trappitsch/stage_controller/README.md

# Stage controller

Multi-axis stage controller repo.

## Crates

The project is divided into multiple crates.
The following list gives an overview.

- `axis_control`: Controls a single axis of a stage.
- `rp2350`: Firmware for stage controller running on an RP2350.
- `icd`: Interface control document: How the device talks to the host.
