trappitsch/stage_controller/hardware/dev_board/xy_table_dev_board.kicad_pcb

## KiCad design hardware/dev_board/xy_table_dev_board.kicad_pcb (2026-09-10)

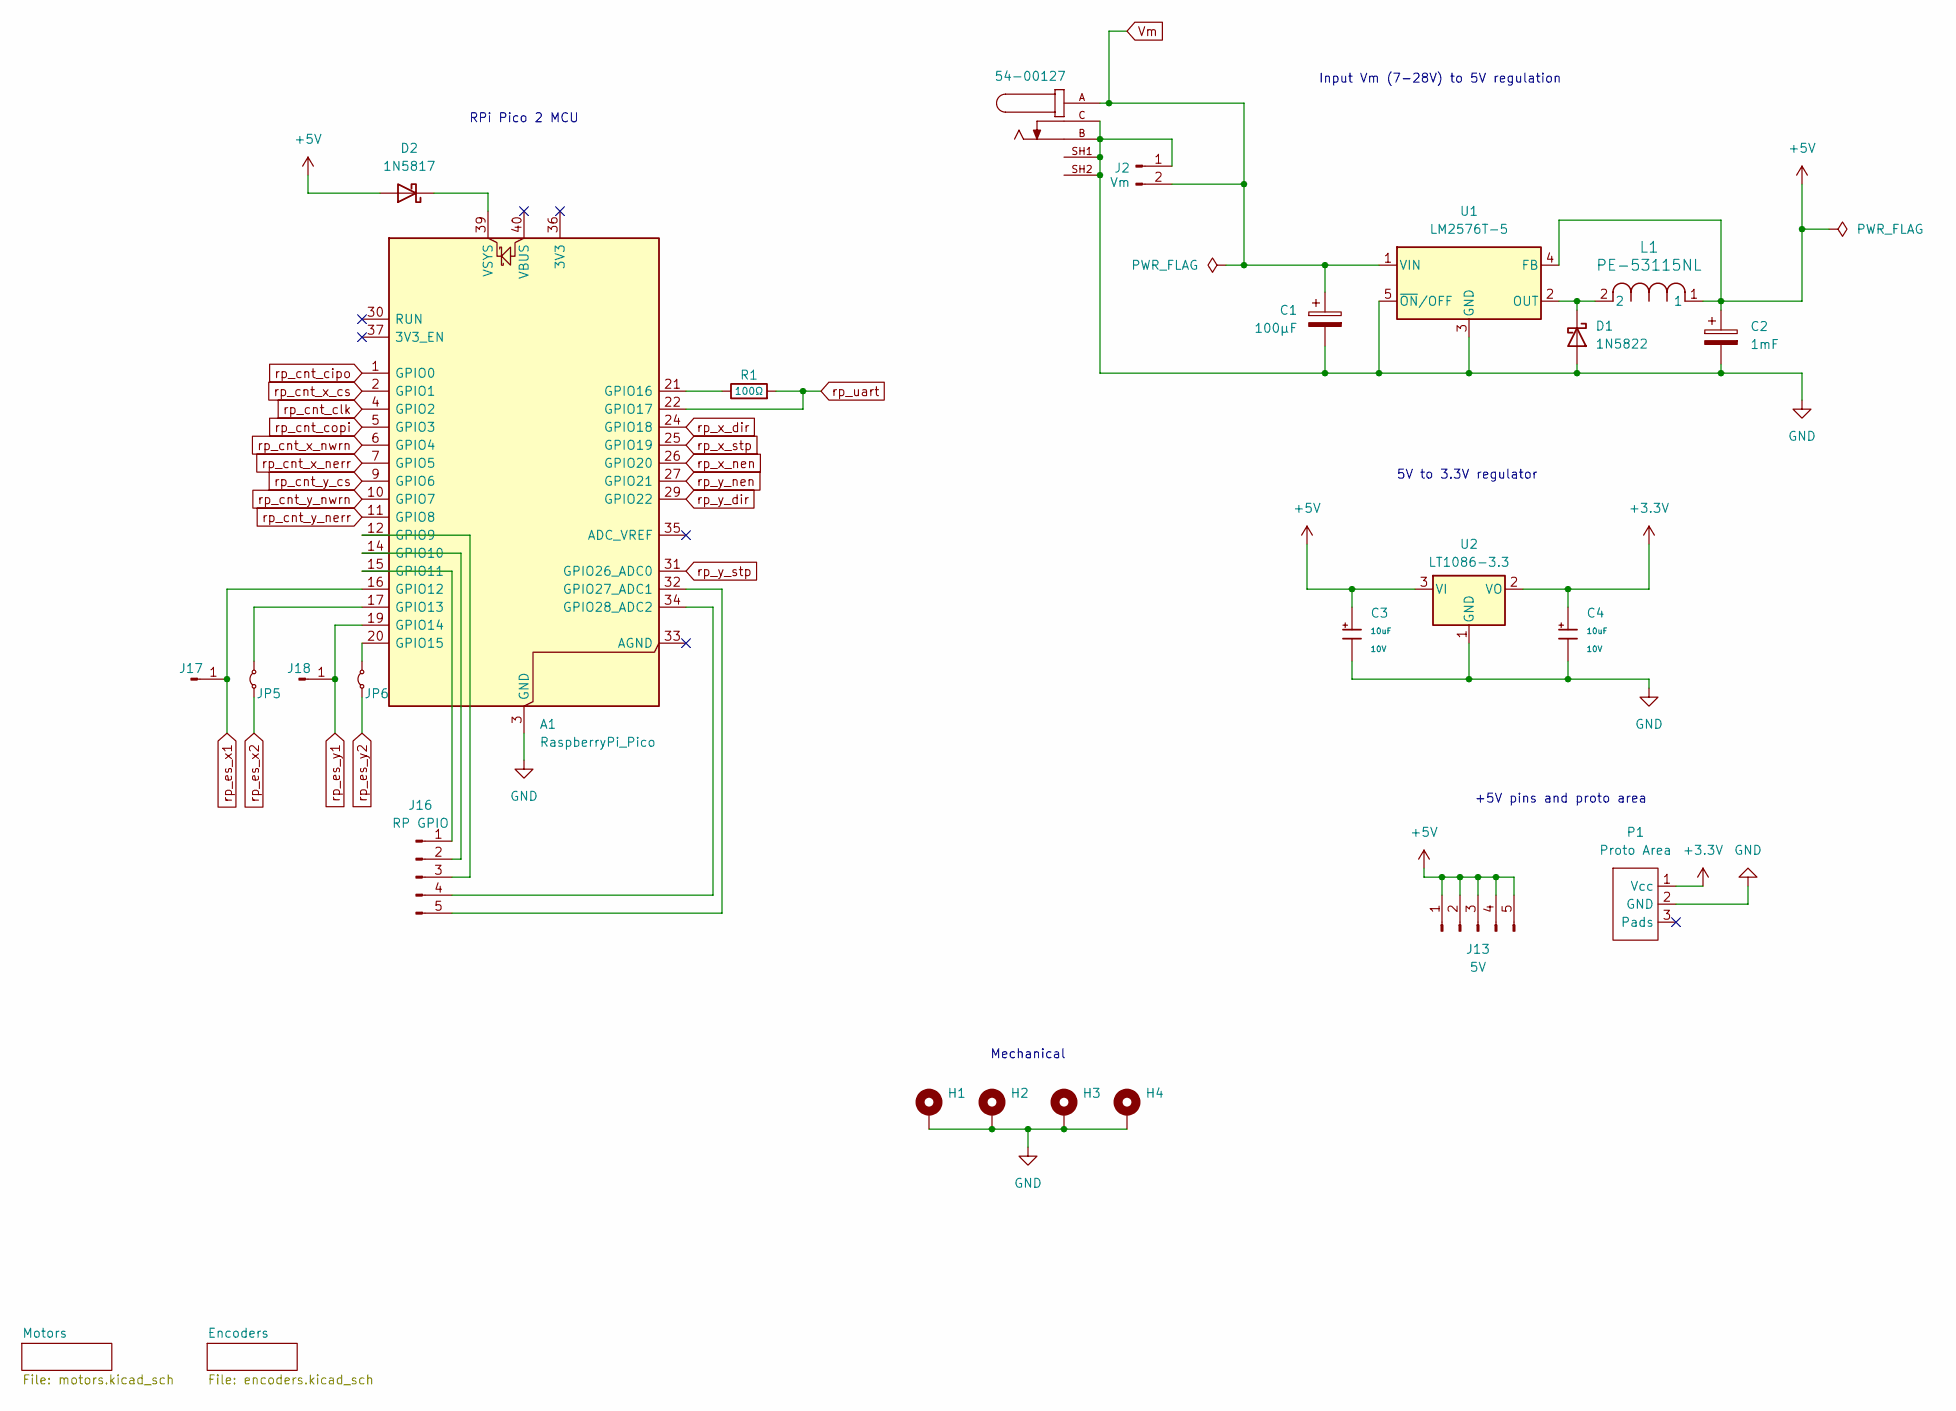
[picture p1: schematic xy_table_dev_board.kicad_sch, XY Table Development board]

Parts:
A1: RaspberryPi_Pico; RaspberryPi_Pico_Common_Unspecified
C1: 100µF; CP_Radial_D6.3mm_P2.50mm; Digikey 732-9215-1-ND
C2: 1mF; CP_Radial_D12.5mm_P5.00mm; Digikey 493-1322-ND
C3, C4: 10uF; C_1206_3216Metric_Pad1.33x1.80mm_HandSolder; Rated Voltage 10V; Digikey 478-11220-2-ND
D1: 1N5822; D_DO-201AD_P15.24mm_Horizontal; Digikey 497-11370-1-ND
D2: 1N5817; D_DO-41_SOD81_P10.16mm_Horizontal
H1, H2, H3, H4: MountingHole_Pad; MountingHole_3.2mm_M3_DIN965_Pad_TopBottom
J1: 54-00127; TENSILITY_54-00127; PARTREV A; Digikey 839-54-00127-ND
J2: Vm; PinHeader_1x02_P2.54mm_Vertical
J13: 5V; PinHeader_1x05_P2.54mm_Vertical
J16: RP GPIO; PinHeader_1x05_P2.54mm_Vertical
J17, J18: Conn_01x01_Pin; PinHeader_1x01_P2.54mm_Vertical
JP5, JP6: Jumper_2_Small_Bridged; TestPoint_2Pads_Pitch2.54mm_Drill0.8mm
L1: PE-53115NL; IND_PE-53115NL_PUL; Digikey 553-1566-5-ND
P1: Proto Area; proto_area_5x20_vcc_gnd
R1: 100Ω; R_1206_3216Metric_Pad1.30x1.75mm_HandSolder
U1: LM2576T-5; TO-220-5_Vertical; Digikey LM2576T-5.0/NOPB-ND
U2: LT1086-3.3; TO-220-3_Vertical

Connections:
+3.3V: C4.1, P1.1 (Vcc), U2.2 (VO); also elsewhere on the board
+5V: C2.1, C3.1, D2.2 (A), J13.1, J13.2, J13.3, J13.4, J13.5, L1.1, U1.4 (FB), U2.3 (VI); also elsewhere on the board
GND: A1.3 (GND), A1.8 (GND), A1.13 (GND), A1.18 (GND), A1.23 (GND), A1.28 (GND), A1.38 (GND), C1.2, C2.2, C3.2, C4.2, D1.2 (A), H1.1 (1_1), H2.1 (1_1), H3.1 (1_1), H4.1 (1_1), J1.B, J1.C, J1.SH1, J1.SH2, J2.1, P1.2 (GND), U1.3 (GND), U1.5 (~ON/OFF), U2.1 (GND); also elsewhere on the board
unnamed: A1.12 (GPIO9), J16.3
unnamed: A1.14 (GPIO10), J16.2
unnamed: A1.15 (GPIO11), J16.1
unnamed: A1.17 (GPIO13), JP5.2 (B)
unnamed: A1.20 (GPIO15), JP6.2 (B)
unnamed: A1.21 (GPIO16), R1.1
unnamed: A1.32 (GPIO27_ADC1), J16.5
unnamed: A1.34 (GPIO28_ADC2), J16.4
unnamed: A1.39 (VSYS), D2.1 (K)
unnamed: D1.1 (K), L1.2, U1.2 (OUT)
Vm: C1.1, J1.A, J2.2, U1.1 (VIN); also elsewhere on the board
rp_cnt_cipo: A1.1 (GPIO0); also elsewhere on the board
rp_cnt_clk: A1.4 (GPIO2); also elsewhere on the board
rp_cnt_copi: A1.5 (GPIO3); also elsewhere on the board
rp_cnt_x_cs: A1.2 (GPIO1); also elsewhere on the board
rp_cnt_x_nerr: A1.7 (GPIO5); also elsewhere on the board
rp_cnt_x_nwrn: A1.6 (GPIO4); also elsewhere on the board
rp_cnt_y_cs: A1.9 (GPIO6); also elsewhere on the board
rp_cnt_y_nerr: A1.11 (GPIO8); also elsewhere on the board
rp_cnt_y_nwrn: A1.10 (GPIO7); also elsewhere on the board
rp_es_x1: A1.16 (GPIO12), J17.1 (Pin_1_1); also elsewhere on the board
rp_es_x2: JP5.1 (A); also elsewhere on the board
rp_es_y1: A1.19 (GPIO14), J18.1 (Pin_1_1); also elsewhere on the board
rp_es_y2: JP6.1 (A); also elsewhere on the board
rp_uart: A1.22 (GPIO17), R1.2; also elsewhere on the board
rp_x_dir: A1.24 (GPIO18); also elsewhere on the board
rp_x_nen: A1.26 (GPIO20); also elsewhere on the board
rp_x_stp: A1.25 (GPIO19); also elsewhere on the board
rp_y_dir: A1.29 (GPIO22); also elsewhere on the board
rp_y_nen: A1.27 (GPIO21); also elsewhere on the board
rp_y_stp: A1.31 (GPIO26_ADC0); also elsewhere on the board

Notes on the sheet:
RPi Pico 2 MCU
Input Vm (7-28V) to 5V regulation
+5V pins and proto area
5V to 3.3V regulator
Mechanical

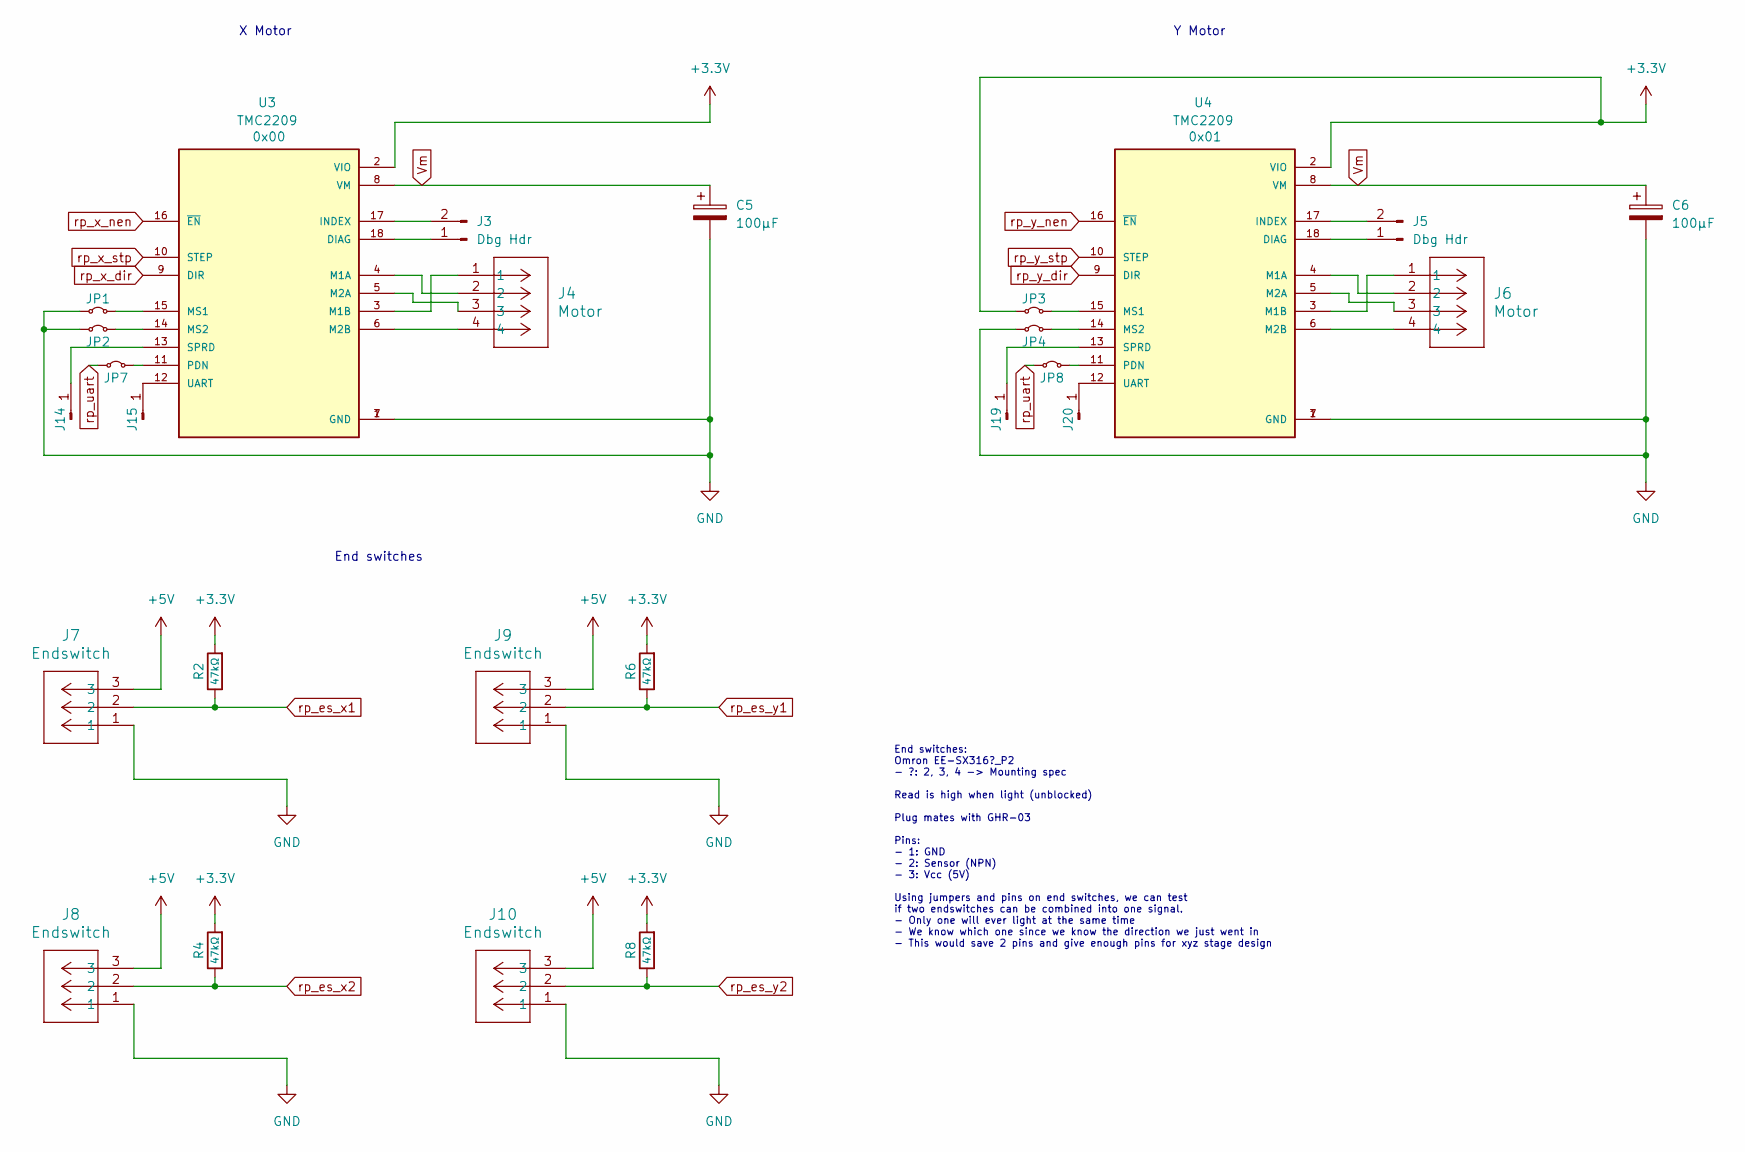
[picture p2: schematic motors.kicad_sch, XY Table Development board]

Parts:
C5, C6: 100µF; CP_Radial_D6.3mm_P2.50mm; Digikey 732-9215-1-ND
J3, J5: Dbg Hdr; PinHeader_1x02_P2.54mm_Vertical
J4, J6: Motor; CONN_A-6373-04A_MOL; Digikey WM2702-ND
J7, J8, J9, J10: Endswitch; CONN_A-6373-03A_MOL; Digikey WM2701-ND
J14, J15, J19, J20: Conn_01x01_Pin; PinHeader_1x01_P2.54mm_Vertical
JP1, JP2, JP3, JP4, JP7, JP8: Jumper_2_Small_Bridged; TestPoint_2Pads_Pitch2.54mm_Drill0.8mm
R2, R4, R6, R8: 47kΩ; R_Axial_DIN0207_L6.3mm_D2.5mm_P7.62mm_Horizontal; Digikey CF18JT47K0TR-ND
U3, U4: TMC2209; MODULE_TMC2209_SILENTSTEPSTICK; PARTREV 1.20

Connections:
+3.3V: JP3.1 (A), R2.2, R4.2, R6.2, R8.2, U3.2 (VIO), U4.2 (VIO); also elsewhere on the board
+5V: J7.3, J8.3, J9.3, J10.3; also elsewhere on the board
GND: C5.2, C6.2, J7.1, J8.1, J9.1, J10.1, JP1.1 (A), JP2.1 (A), JP4.1 (A), U3.1 (GND), U3.7 (GND), U4.1 (GND), U4.7 (GND); also elsewhere on the board
unnamed: J3.1, U3.18 (DIAG)
unnamed: J3.2, U3.17 (INDEX)
unnamed: J5.1, U4.18 (DIAG)
unnamed: J5.2, U4.17 (INDEX)
unnamed: J14.1 (Pin_1_1), U3.13 (SPRD)
unnamed: J15.1 (Pin_1_1), U3.12 (UART)
unnamed: J19.1 (Pin_1_1), U4.13 (SPRD)
unnamed: J20.1 (Pin_1_1), U4.12 (UART)
unnamed: JP1.2 (B), U3.15 (MS1)
unnamed: JP2.2 (B), U3.14 (MS2)
unnamed: JP3.2 (B), U4.15 (MS1)
unnamed: JP4.2 (B), U4.14 (MS2)
unnamed: JP7.2 (B), U3.11 (PDN)
unnamed: JP8.2 (B), U4.11 (PDN)
unnamed: J4.2, U3.4 (M1A)
unnamed: J4.1, U3.3 (M1B)
unnamed: J4.3, U3.5 (M2A)
unnamed: J4.4, U3.6 (M2B)
unnamed: J6.2, U4.4 (M1A)
unnamed: J6.1, U4.3 (M1B)
unnamed: J6.3, U4.5 (M2A)
unnamed: J6.4, U4.6 (M2B)
Vm: C5.1, C6.1, U3.8 (VM), U4.8 (VM); also elsewhere on the board
rp_es_x1: J7.2, R2.1; also elsewhere on the board
rp_es_x2: J8.2, R4.1; also elsewhere on the board
rp_es_y1: J9.2, R6.1; also elsewhere on the board
rp_es_y2: J10.2, R8.1; also elsewhere on the board
rp_uart: JP7.1 (A), JP8.1 (A); also elsewhere on the board
rp_x_dir: U3.9 (DIR); also elsewhere on the board
rp_x_nen: U3.16 (~EN); also elsewhere on the board
rp_x_stp: U3.10 (STEP); also elsewhere on the board
rp_y_dir: U4.9 (DIR); also elsewhere on the board
rp_y_nen: U4.16 (~EN); also elsewhere on the board
rp_y_stp: U4.10 (STEP); also elsewhere on the board

Notes on the sheet:
Y Motor
End switches: Omron EE-SX316?_P2 - ?: 2, 3, 4 -> Mounting spec Read is high when light (unblocked) Plug mates with GHR-03 Pins: - 1: GND - 2: Sensor (NPN) - 3: Vcc (5V) Using jumpers and pins on end switches, we can test if two endswitches can be combined into one signal. - Only one will ever light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
End switches
X Motor

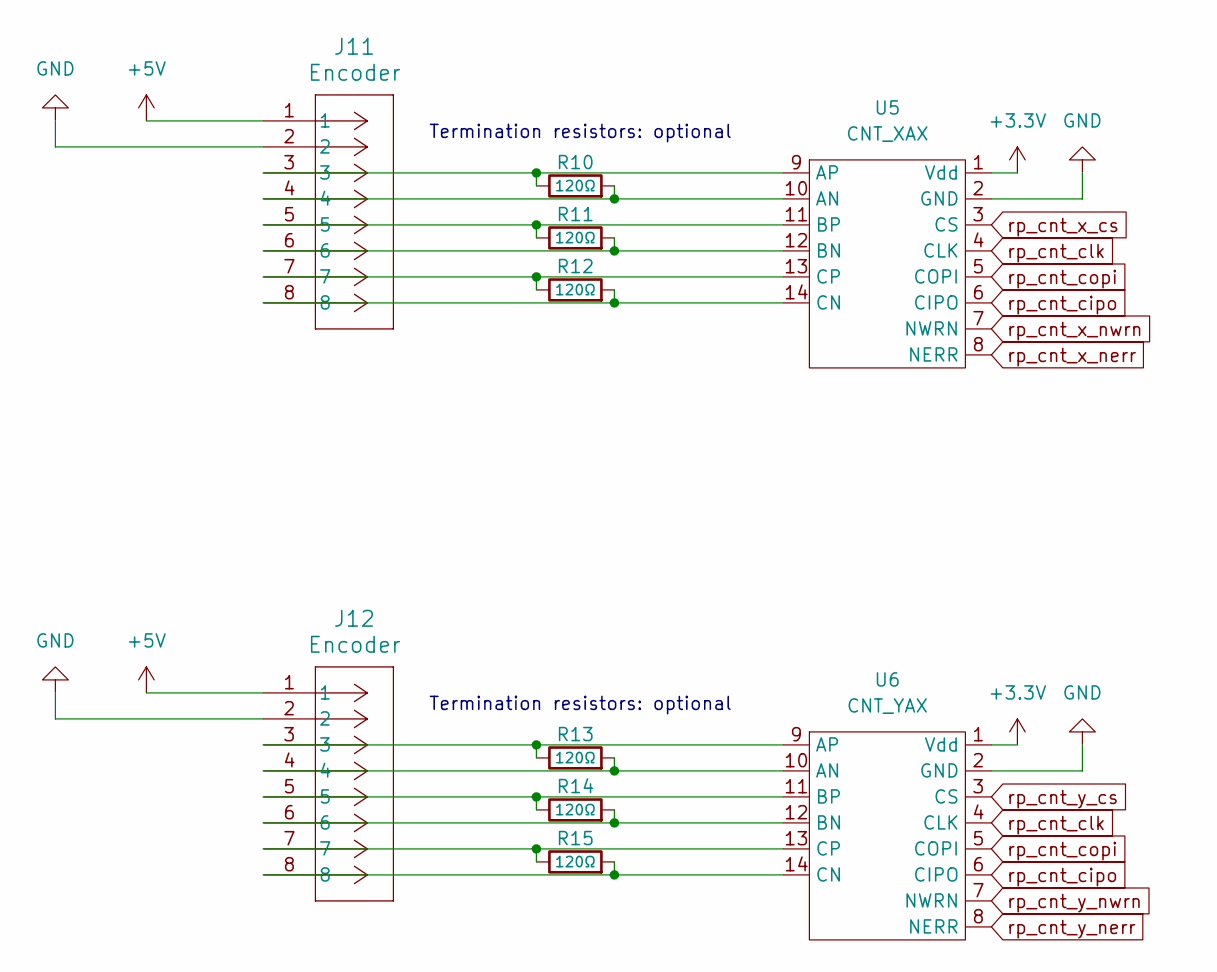
[picture p3: schematic encoders.kicad_sch, XY Table Development board]

Parts:
J11, J12: Encoder; CONN_A-6373-08A_MOL; Digikey 900-0022112082-ND
R10, R11, R12, R13, R14, R15: 120Ω; R_Axial_DIN0207_L6.3mm_D2.5mm_P7.62mm_Horizontal
U5: CNT_XAX; iC-MD_brd_5VSig_3.3Vcc
U6: CNT_YAX; iC-MD_brd_5VSig_3.3Vcc

Connections:
+3.3V: U5.1 (Vdd), U6.1 (Vdd); also elsewhere on the board
+5V: J11.1, J12.1; also elsewhere on the board
GND: J11.2, J12.2, U5.2 (GND), U6.2 (GND); also elsewhere on the board
unnamed: J11.4, R10.2, U5.10 (AN)
unnamed: J11.3, R10.1, U5.9 (AP)
unnamed: J11.6, R11.2, U5.12 (BN)
unnamed: J11.5, R11.1, U5.11 (BP)
unnamed: J11.8, R12.2, U5.14 (CN)
unnamed: J11.7, R12.1, U5.13 (CP)
unnamed: J12.4, R13.2, U6.10 (AN)
unnamed: J12.3, R13.1, U6.9 (AP)
unnamed: J12.6, R14.2, U6.12 (BN)
unnamed: J12.5, R14.1, U6.11 (BP)
unnamed: J12.8, R15.2, U6.14 (CN)
unnamed: J12.7, R15.1, U6.13 (CP)
rp_cnt_cipo: U5.6 (CIPO), U6.6 (CIPO); also elsewhere on the board
rp_cnt_clk: U5.4 (CLK), U6.4 (CLK); also elsewhere on the board
rp_cnt_copi: U5.5 (COPI), U6.5 (COPI); also elsewhere on the board
rp_cnt_x_cs: U5.3 (CS); also elsewhere on the board
rp_cnt_x_nerr: U5.8 (NERR); also elsewhere on the board
rp_cnt_x_nwrn: U5.7 (NWRN); also elsewhere on the board
rp_cnt_y_cs: U6.3 (CS); also elsewhere on the board
rp_cnt_y_nerr: U6.8 (NERR); also elsewhere on the board
rp_cnt_y_nwrn: U6.7 (NWRN); also elsewhere on the board

Notes on the sheet:
Termination resistors: optional

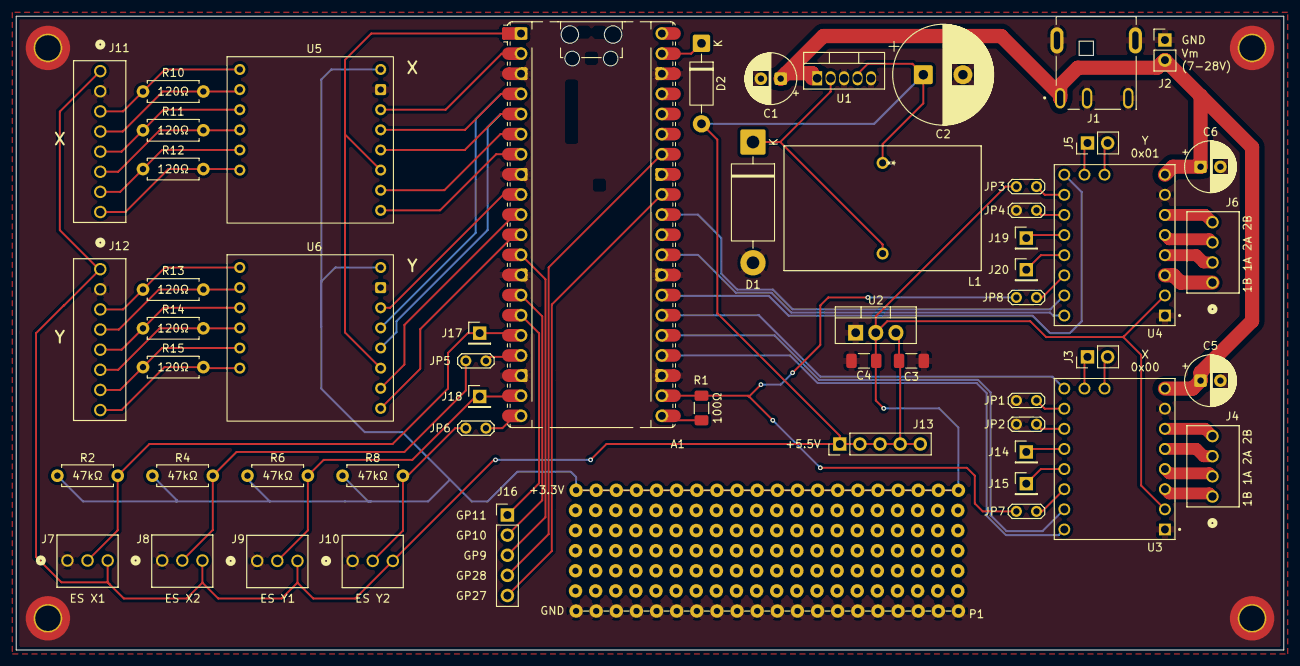
[picture p4: board xy_table_dev_board.kicad_pcb from above]

Board: 2 copper layers, 160.0 x 80.0 mm, 60 parts (0 on the bottom side), 68 nets.
