trappitsch/stage_controller/(commit log)

2026-09-10 Init repo, add KiCad dev board (first version)
    [encoders.kicad_sch, motors.kicad_sch, xy_table_dev_board.kicad_pcb, xy_table_dev_board.kicad_sch]
2026-10-30 add first version of encoder, some fixes to motor
    [icmd.rs, lib.rs, mod.rs, tmc2209.rs]
2026-10-30 add some first and rough PIO control for motors
2026-11-10 First PIO implementation for motor movements
    - motors move simultaneously.
    - motors use one PIO, two state machines.
